Hanley-Research-Group/CTR-Prototype/docs/CTCR 4_9 Design Decision_ MDF alternative.pdf

- Problem: MDF will literally ignite instantly and put glue fumes into the air and the writers of the paper are idiots for not using a different material.
- Easy solution: Use Macor
- Macor price: $448
- I would be scared of chipping it and doing a bad job…
- https://www.mcmaster.com/products/macor-ceramic/
○
- Other materials that have above 500C active use are similarly expensive or very hard to machine…
- Alternative: Glass-Bonded Mica (Mycalex) (Has a lower operating temperature but doesnt instantly fail and will be fine for short bursts
- Mycalex Price: $175.81
- https://www.mcmaster.com/products/macor-ceramic/
- Does create a fine powder – would need to hook up special apparatus to Carvera ■ https://www.youtube.com/watch?v=_iFvw3WZiss
- Calcium Silicate
- Very inexpensive, fine powders but bad tolerance +-0.1mm (WHICH IS ACTUALLY STANDARD – compares to aluminum
■ 9353K31 (https://www.mcmaster.com/9353K31/)
