Hanley-Research-Group/CTR-Prototype/pcb/hardware/TUBER copy.kicad_pcb

## KiCad design pcb/hardware/TUBER copy.kicad_pcb (2026-09-18)

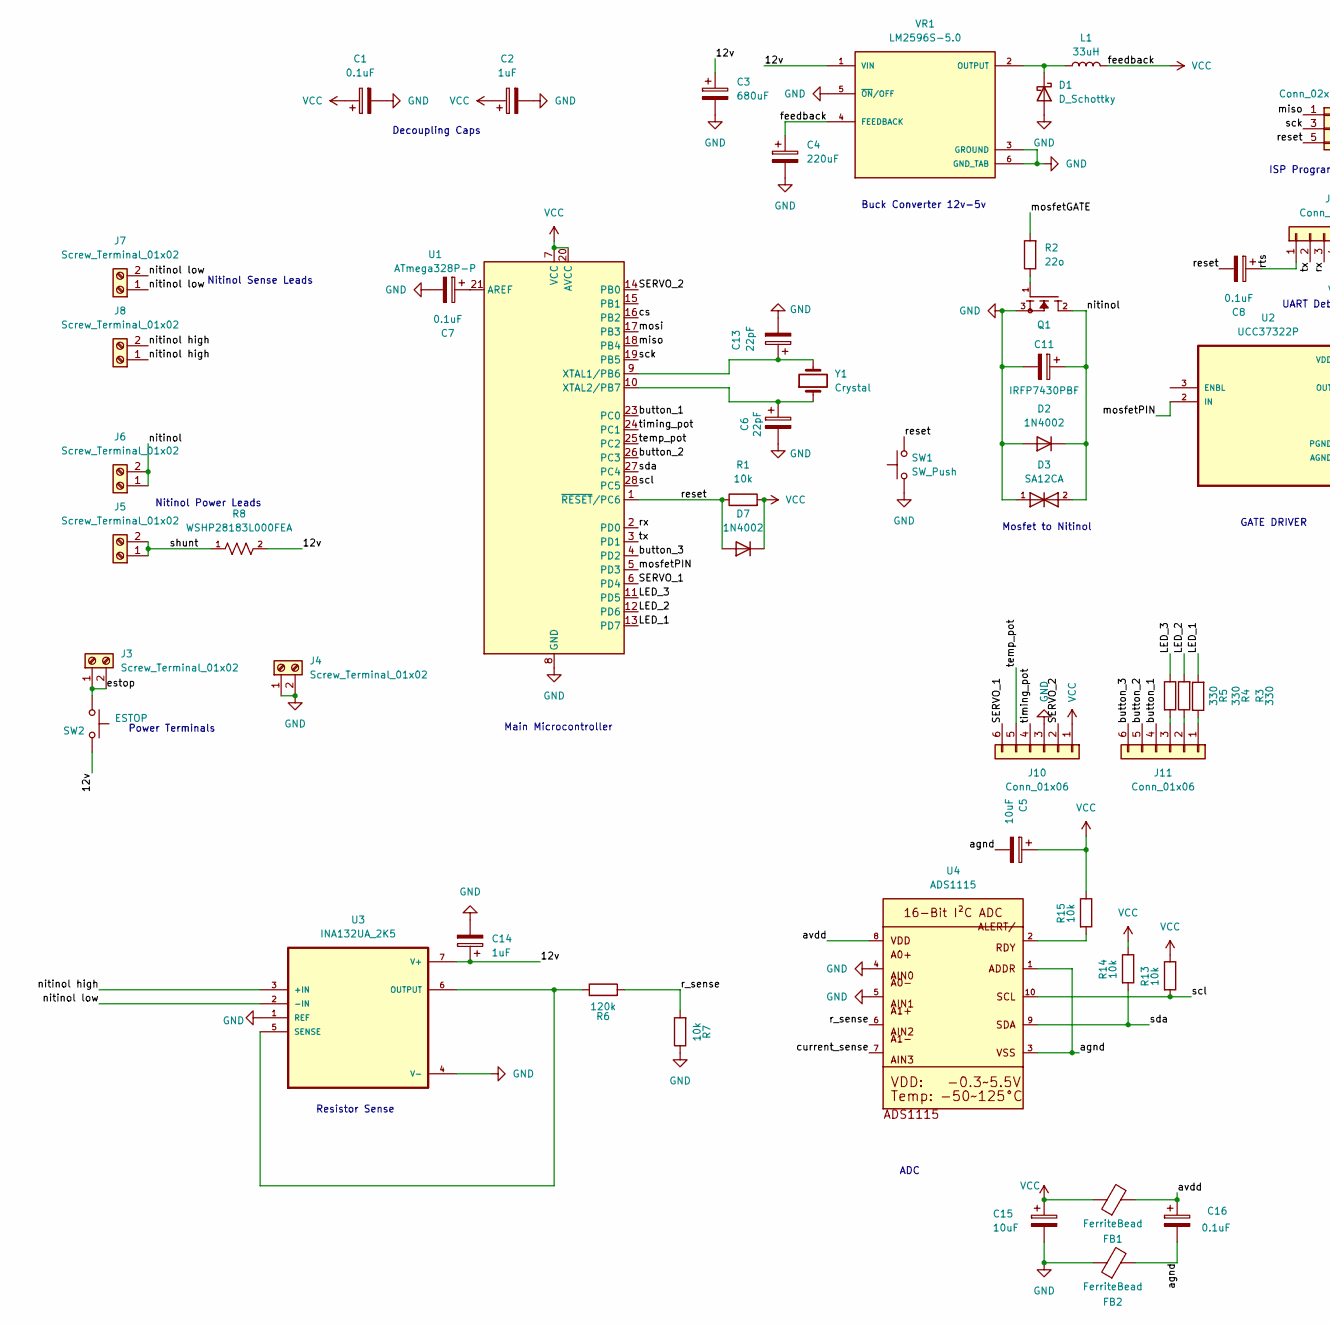
[picture p1: schematic TUBER copy.kicad_sch, part in row 1, column 1]

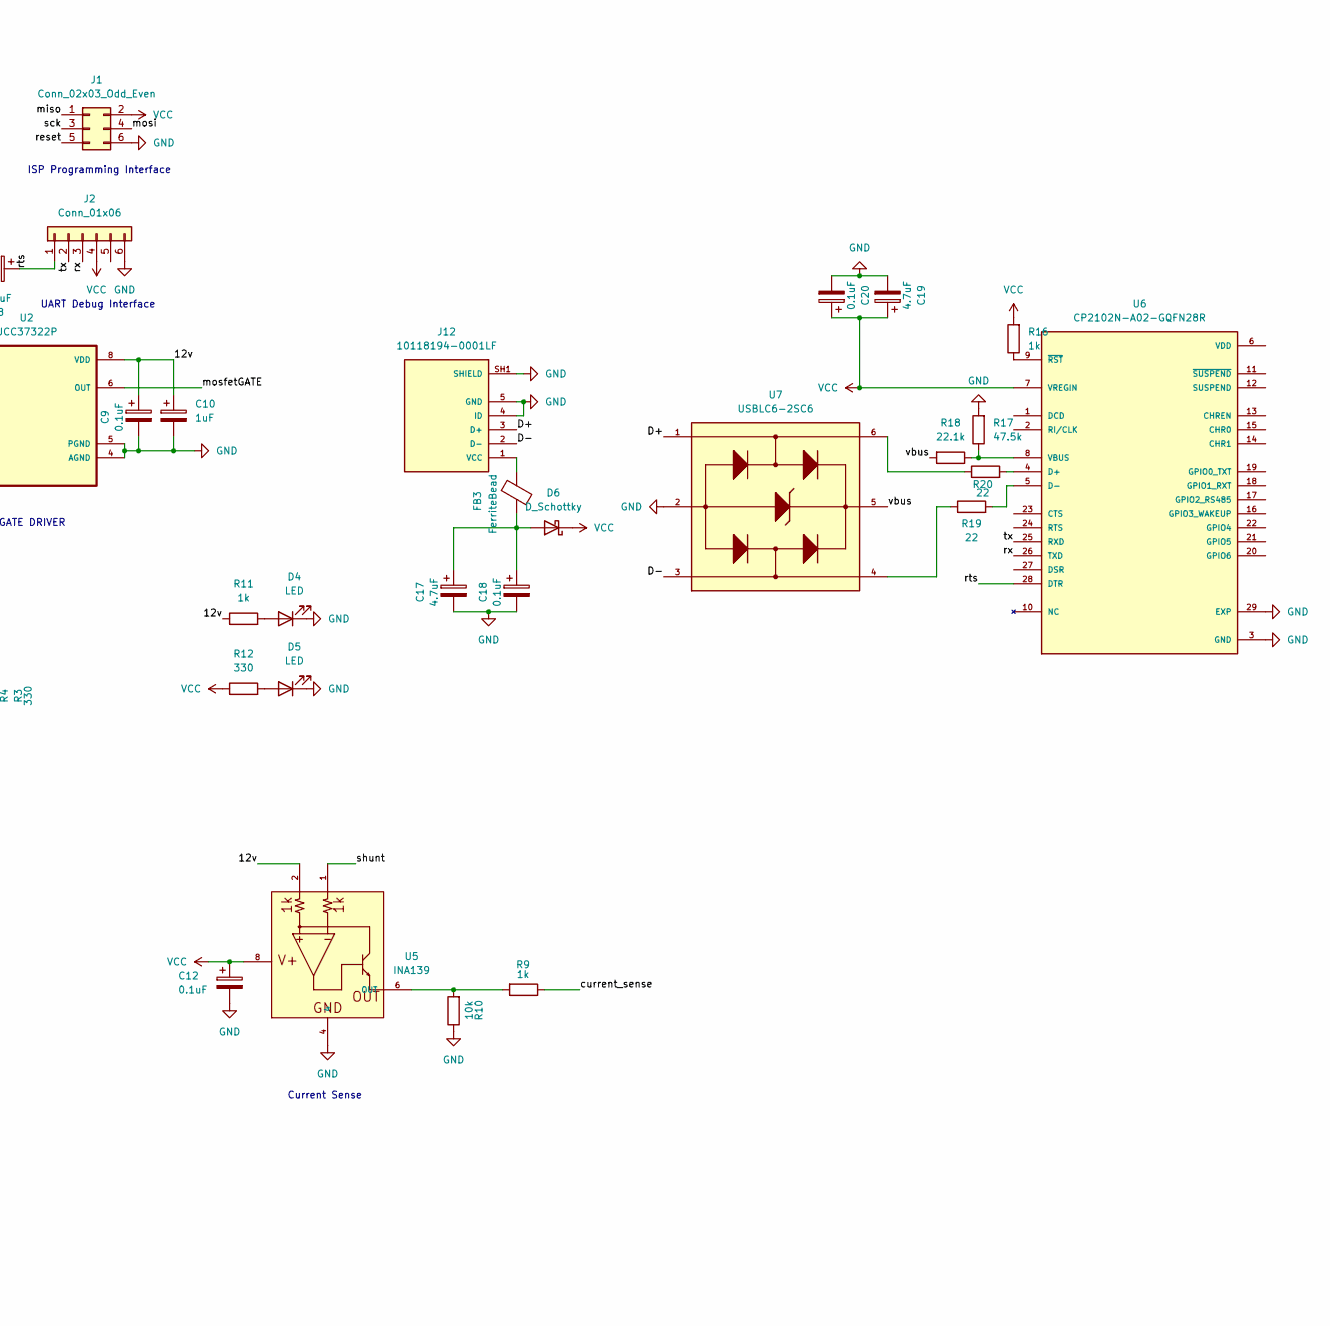
[picture p2: schematic TUBER copy.kicad_sch, part in row 1, column 2]

Parts:
C1, C7, C8, C9, C12, C16, C18, C20: 0.1uF; C_1206_3216Metric_Pad1.33x1.80mm_HandSolder
C2, C10, C14: 1uF; CP_Radial_D5.0mm_P2.50mm
C3: 680uF; CP_Radial_D8.0mm_P3.50mm
C4: 220uF; CP_Radial_D5.0mm_P2.50mm
C5, C15: 10uF; C_1206_3216Metric_Pad1.33x1.80mm_HandSolder
C6, C13: 22pF; C_1206_3216Metric_Pad1.33x1.80mm_HandSolder
C11: 1uF; C_Rect_L7.2mm_W4.5mm_P5.00mm
C17, C19: 4.7uF; CP_Radial_D5.0mm_P2.50mm
D1, D6: D_Schottky; DIOAD2120W130L950D530P
D2, D7: 1N4002; D_DO-41_SOD81_P10.16mm_Horizontal
D3: SA12CA; DO-15B-10
D4, D5: LED; LED_1206_3216Metric_Pad1.42x1.75mm_HandSolder
FB1, FB2, FB3: FerriteBead; BEADC1608X95N
J1: Conn_02x03_Odd_Even; PinHeader_2x03_P2.54mm_Vertical
J2: Conn_01x06; PinHeader_1x06_P2.54mm_Vertical
J3, J4, J5, J6, J7, J8: Screw_Terminal_01x02; TerminalBlock_Xinya_XY308-2.54-2P_1x02_P2.54mm_Horizontal
J10, J11: Conn_01x06; JST_XH_B6B-XH-AM_1x06_P2.50mm_Vertical
J12: 10118194-0001LF; AMPHENOL_10118194-0001LF; PARTREV D
L1: 33uH; INDM3225X240N
Q1: IRFP7430PBF; TO546P1558X498X2499-3; PARTREV 2/19/2015
R1, R7, R10, R13, R14, R15: 10k; R_1206_3216Metric_Pad1.30x1.75mm_HandSolder
R2: 22o; R_1206_3216Metric_Pad1.30x1.75mm_HandSolder
R3, R4, R5, R12: 330; R_1206_3216Metric_Pad1.30x1.75mm_HandSolder
R6: 120k; R_1206_3216Metric_Pad1.30x1.75mm_HandSolder
R8: WSHP28183L000FEA; RES_WSHP28183L000FEA; PARTREV 01-Jan-2026
R9, R11, R16: 1k; R_1206_3216Metric_Pad1.30x1.75mm_HandSolder
R17: 47.5k; R_1206_3216Metric_Pad1.30x1.75mm_HandSolder
R18: 22.1k; R_1206_3216Metric_Pad1.30x1.75mm_HandSolder
R19, R20: 22; R_1206_3216Metric_Pad1.30x1.75mm_HandSolder
SW1: SW_Push; SW_TH_Tactile_Omron_B3F-100x
SW2: ESTOP; SolderWire-0.25sqmm_1x02_P4.5mm_D0.65mm_OD2mm_Relief2x
U1: ATmega328P-P; DIP-28_W7.62mm
U2: UCC37322P; DIP794W45P254L959H508Q8
U3: INA132UA_2K5; SOIC127P599X175-8N
U4: ADS1115; MSOP10
U5: INA139; SOP65P640X120-8N
U6: CP2102N-A02-GQFN28R; IC_CP2102N-A02-GQFN28R; PARTREV 1.5
U7: USBLC6-2SC6; SOT95P280X145-6N
VR1: LM2596S-5.0; TO170P1524X483-6N; PARTREV E
Y1: Crystal; Crystal_HC49-U_Vertical

Connections:
/D+: J12.3 (D+), U7.1
/D-: J12.2 (D-), U7.3
/LED_1: R5.2, U1.13 (PD7)
/LED_2: R4.2, U1.12 (PD6)
/LED_3: R3.1, U1.11 (PD5)
/SERVO_1: J10.6, U1.6 (PD4)
/SERVO_2: J10.2, U1.14 (PB0)
/agnd: C5.2, C16.2, FB2.2, U4.1, U4.3
/avdd: C16.1, FB1.2, U4.8
/button_1: J11.4, U1.23 (PC0)
/button_2: J11.5, U1.26 (PC3)
/button_3: J11.6, U1.4 (PD2)
/cs: U1.16 (PB2)
/current_sense: R9.1, U4.7
/estop: J3.1, J3.2, SW2.1
/miso: J1.1, U1.18 (PB4)
/mosfetGATE: R2.2, U2.6 (OUT), U2.7 (OUT)
/mosfetPIN: U1.5 (PD3), U2.2 (IN)
/mosi: J1.4, U1.17 (PB3)
/nitinol: C11.1, D2.1 (K), D3.2, J6.1, J6.2, Q1.2
/nitinol high: J8.1, J8.2, U3.3 (+IN)
/nitinol low: J7.1, J7.2, U3.2 (-IN)
/r_sense: R6.2, R7.2, U4.6
/reset: C8.2, D7.2 (A), J1.5, R1.1, SW1.2, U1.1 (~RESET/PC6)
/rts: C8.1, J2.1, U6.28 (DTR)
/rx: J2.3, U1.2 (PD0), U6.26 (TXD)
/sck: J1.3, U1.19 (PB5)
/scl: R13.2, U1.28 (PC5), U4.10
/sda: R14.2, U1.27 (PC4), U4.9
/shunt: J5.1, J5.2, R8.1, U5.1
/temp_pot: J10.5, U1.25 (PC2)
/timing_pot: J10.4, U1.24 (PC1)
/tx: J2.2, U1.3 (PD1), U6.25 (RXD)
/vbus: R18.2, U7.5
GND: C1.2, C2.2, C3.2, C4.2, C6.2, C7.2, C9.2, C10.2, C11.2, C12.2, C13.2, C14.2, C15.2, C17.2, C18.2, C19.2, C20.2, D1.2 (A), D2.2 (A), D3.1, D4.1 (K), D5.1 (K), FB2.1, J1.6, J2.6, J4.1, J4.2, J10.3, J12.4 (ID), J12.5 (GND), J12.SH1 (SHIELD), J12.SH2 (SHIELD), J12.SH3 (SHIELD), J12.SH4 (SHIELD), J12.SH5 (SHIELD), J12.SH6 (SHIELD), Q1.3, R7.1, R10.1, R17.2, SW1.1, U1.8 (GND), U1.22 (GND), U2.4 (AGND), U2.5 (PGND), U3.1 (REF), U3.4 (V-), U4.4, U4.5, U5.4, U6.3 (GND), U6.29 (EXP), U7.2, VR1.3 (GROUND), VR1.5 (~ON/OFF), VR1.6 (GND_TAB)
unnamed: D1.1 (K), L1.1, VR1.2 (OUTPUT)
unnamed: D4.2 (A), R11.2
unnamed: D5.2 (A), R12.2
unnamed: C17.1, C18.1, D6.2 (A), FB3.2
unnamed: J11.1, R5.1
unnamed: J11.2, R4.1
unnamed: J11.3, R3.2
unnamed: FB3.1, J12.1 (VCC)
unnamed: Q1.1, R2.1
unnamed: R15.2, U4.2
unnamed: R19.1, U7.4
unnamed: R20.1, U7.6
unnamed: C7.1, U1.21 (AREF)
unnamed: C13.1, U1.9 (XTAL1/PB6), Y1.2
unnamed: C6.1, U1.10 (XTAL2/PB7), Y1.1
unnamed: R6.1, U3.5 (SENSE), U3.6 (OUTPUT)
unnamed: R9.2, R10.2, U5.6 (OUT)
unnamed: R20.2, U6.4 (D+)
unnamed: R19.2, U6.5 (D-)
unnamed: R17.1, R18.1, U6.8 (VBUS)
unnamed: R16.1, U6.9 (~RST)
VCC: C1.1, C2.1, C4.1, C5.1, C12.1, C15.1, C19.1, C20.1, D6.1 (K), D7.1 (K), FB1.1, J1.2, J2.4, J10.1, L1.2, R1.2, R12.1, R13.1, R14.1, R15.1, R16.2, U1.7 (VCC), U1.20 (AVCC), U5.8, U6.7 (VREGIN), VR1.4 (FEEDBACK)
VDD: C3.1, C9.1, C10.1, C14.1, R8.2, R11.1, SW2.2, U2.1 (VDD), U2.8 (VDD), U3.7 (V+), U5.2, VR1.1 (VIN)

Notes on the sheet:
Nitinol Sense Leads
GATE DRIVER
Decoupling Caps
Power Terminals
ISP Programming Interface
Current Sense
UART Debug Interface
ADC
Buck Converter 12v-5v
Nitinol Power Leads
Mosfet to Nitinol
Resistor Sense
Main Microcontroller

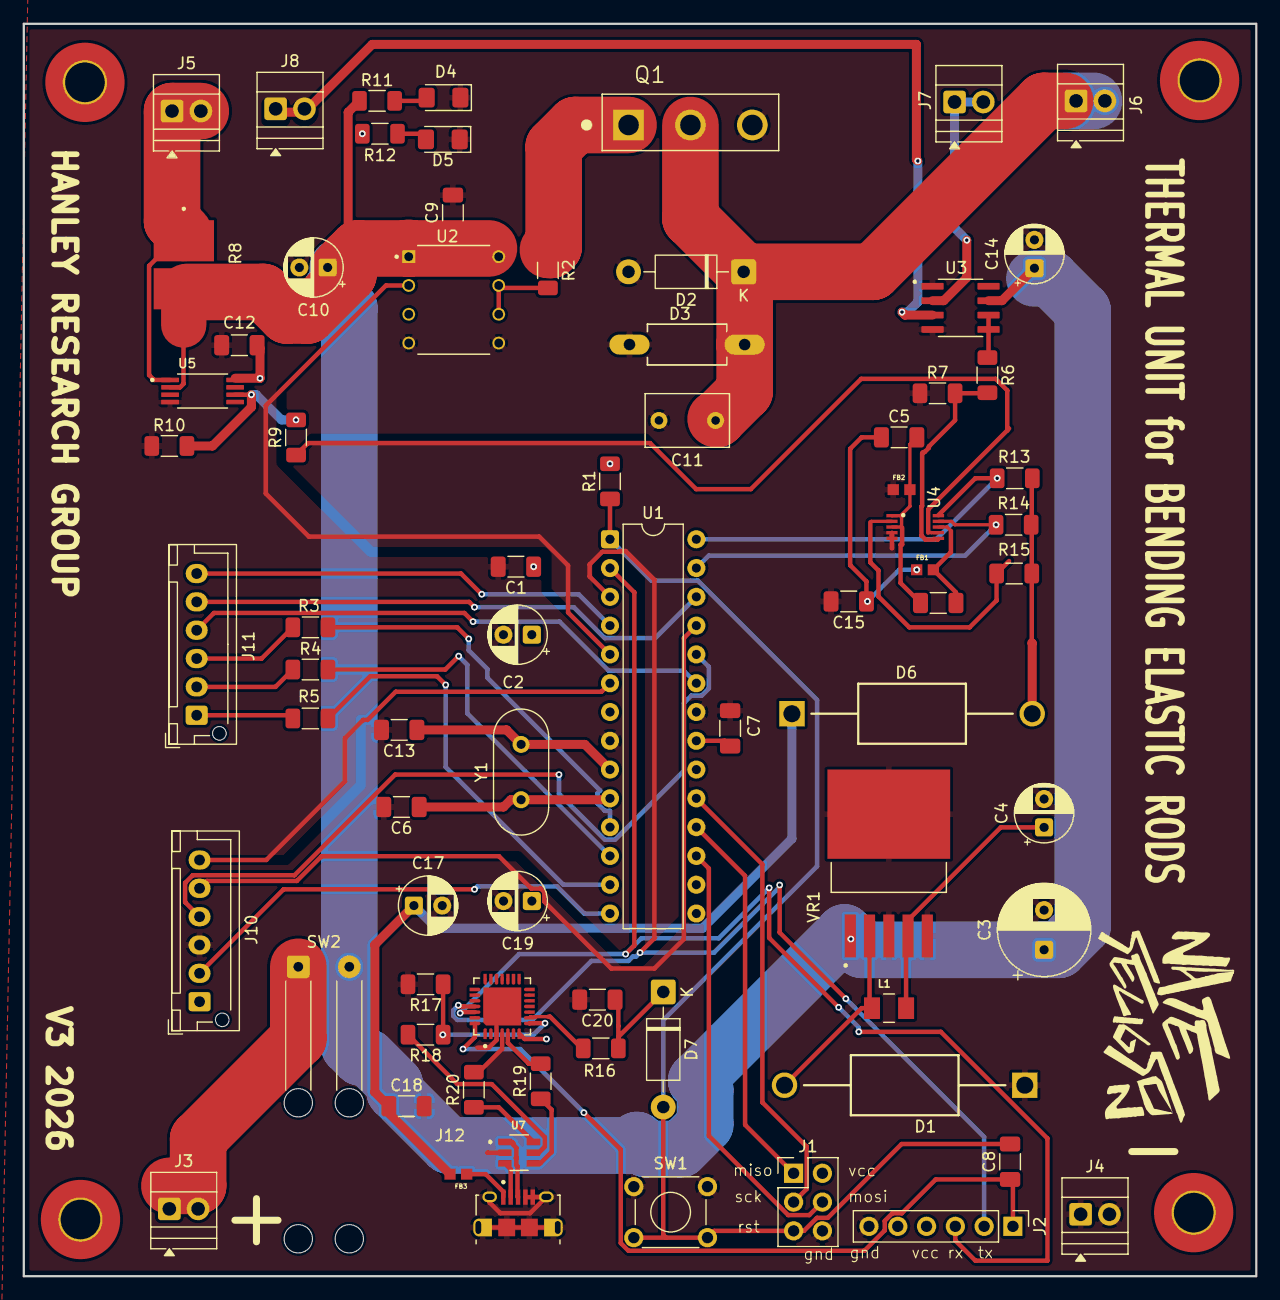
[picture p3: board TUBER copy.kicad_pcb from above]

Board: 2 copper layers, 108.7 x 110.5 mm, 74 parts (0 on the bottom side), 57 nets.
